conegiorno/StanowiskoChwytak/README.md

#### Budowa stanowiska do rozwoju metod estymacji siły chwytu chwytaka antropomorficznego
Niniejsze repozytorium jest projektem pracy magisterskiej.
