conegiorno/StanowiskoChwytak/(list of files, cad)

Other CAD files:
mechanical_parts/gripper/assembly/zlozenie_naped_v2.iam
mechanical_parts/gripper/assembly/zlozenie_palec_lewy.iam
mechanical_parts/gripper/assembly/zlozenie_palec_prawy.iam
mechanical_parts/gripper/assembly/zlozenie_ramka.iam
mechanical_parts/gripper/assembly/zlozenie_wszystko.iam
mechanical_parts/gripper/parts/belka_poprzeg.ipt
mechanical_parts/gripper/parts/belka_wzdluz.ipt
mechanical_parts/gripper/parts/czujnik_nacisku.ipt
mechanical_parts/gripper/parts/finger_rig.ipt
mechanical_parts/gripper/parts/holder_v2.ipt
mechanical_parts/gripper/parts/kolo_napedowe.ipt
mechanical_parts/gripper/parts/motor_clamp_v2.ipt
mechanical_parts/gripper/parts/motor_rig_v2.ipt
mechanical_parts/gripper/parts/motor_rig_v3.ipt
mechanical_parts/gripper/parts/nit_skrecany.ipt
mechanical_parts/gripper/parts/opuszek.ipt
mechanical_parts/gripper/parts/palec1.ipt
mechanical_parts/gripper/parts/palec2.ipt
mechanical_parts/gripper/parts/palec3.ipt
mechanical_parts/gripper/parts/paliczek_v2.ipt
mechanical_parts/gripper/parts/pokrywka.ipt
mechanical_parts/gripper/parts/potencjometr.ipt
mechanical_parts/gripper/parts/potentiometr_case.ipt
mechanical_parts/gripper/parts/pret20mm.ipt
mechanical_parts/gripper/parts/pret22mm.ipt
mechanical_parts/gripper/parts/tuleja.ipt
mechanical_parts/gripper/parts/tweaker.ipt
mechanical_parts/gripper/parts/wciskacz_v2.ipt
mechanical_parts/sensor_accesoories/hemisphere_1.ipt
mechanical_parts/sensor_accesoories/hemisphere_2.ipt
mechanical_parts/sensor_accesoories/noga1.ipt
mechanical_parts/sensor_accesoories/noga2.ipt
mechanical_parts/sensor_accesoories/semicylinder_1.ipt
mechanical_parts/sensor_accesoories/semicylinder_2.ipt
mechanical_parts/sensor_accesoories/stojak.iam
mechanical_parts/sensor_accesoories/stojak.ipt
