conegiorno/StanowiskoChwytak/documentation/schemat_elektroniczny.pdf

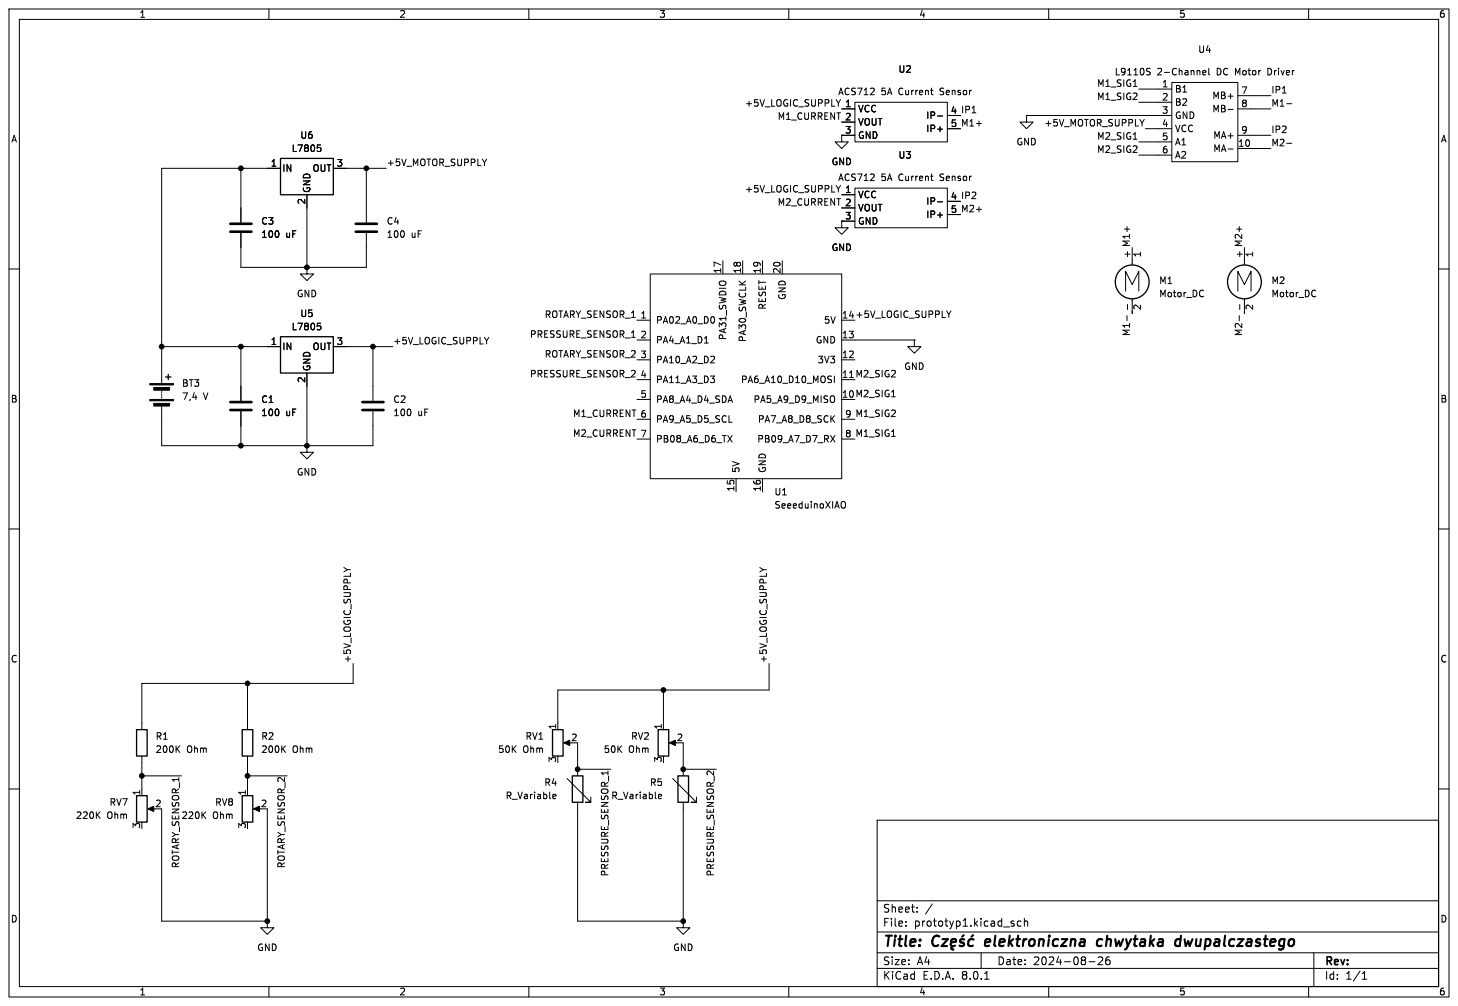
[picture p1: page 1]

GND
ACS712 5A Current Sensor VCC 1 VOUT 2 GND 3

2 OUT 3 U2 VCC 1 VOUT 2 GND 3
