conegiorno/StanowiskoChwytak/documentation/zlozenie_naped.pdf

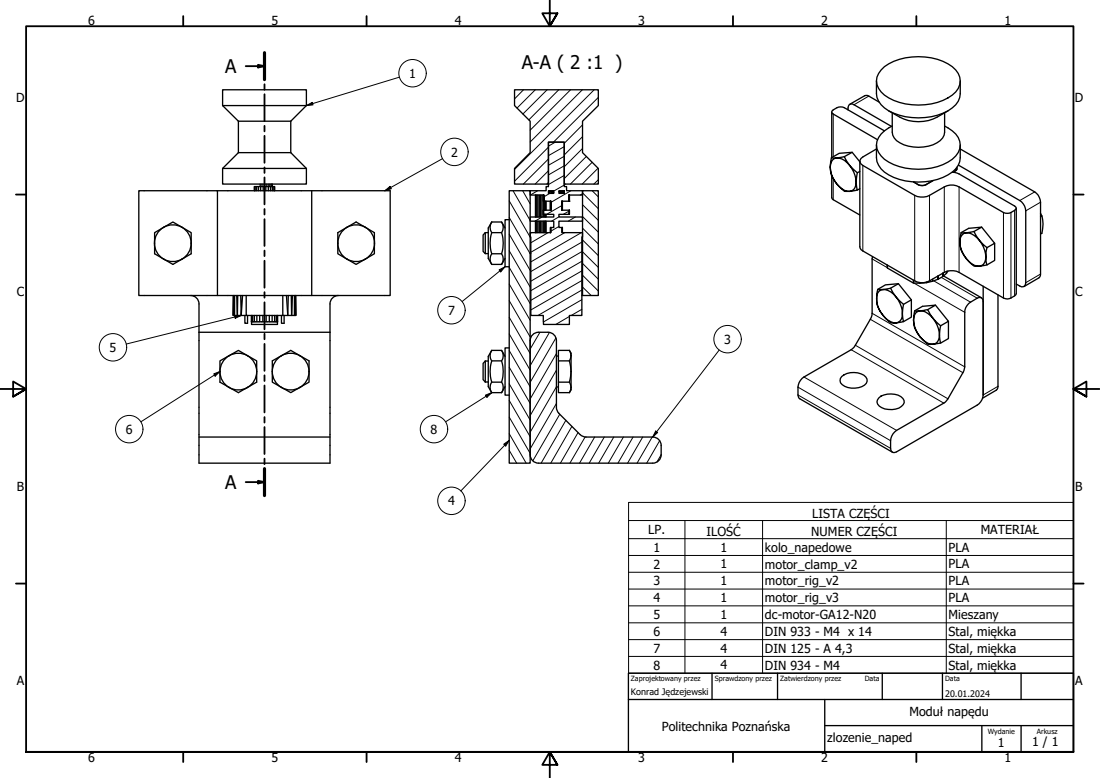
[picture p2: page 1]
LISTA CZĘŚCI

LP. | ILOŚĆ | NUMER CZĘŚCI | MATERIAŁ
1 | 1 | kolo_napedowe | PLA
2 | 1 | motor_clamp_v2 | PLA
3 | 1 | motor_rig_v2 | PLA
4 | 1 | motor_rig_v3 | PLA
5 | 1 | dc-motor-GA12-N20 | Mieszany
6 | 4 | DIN 933 - M4 x 14 | Stal, miękka
7 | 4 | DIN 125 - A 4,3 | Stal, miękka
8 | 4 | DIN 934 - M4 | Stal, miękka
Zaprojektowany przez Konrad Jędzejewski | Sprawdzony przez | Zatwierdzony przez Data | | Data 20.01.2024

Politechnika Poznańska | Moduł napędu

zlozenie_naped | Wydanie 1 | Arkusz 1 / 1
