conegiorno/StanowiskoChwytak/documentation/zlozenie_palec_lewy.pdf

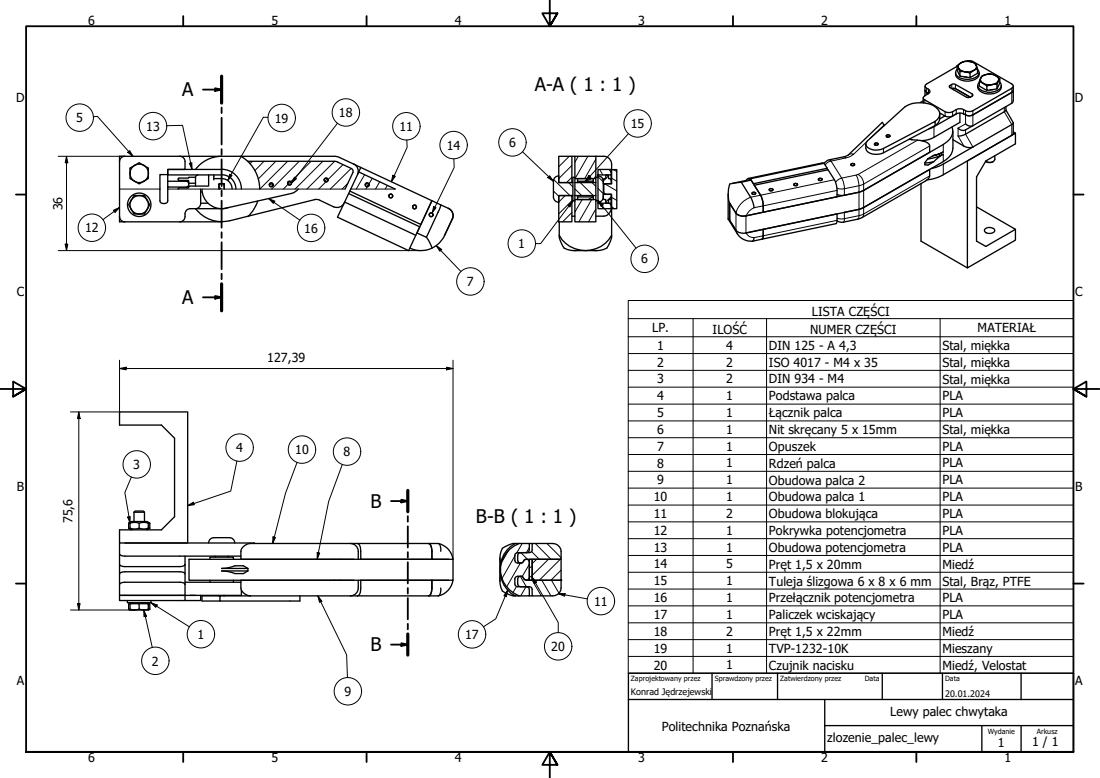
[picture p3: page 1]

L P . | Ś Ć I L O | Ś N U M E R C Z Ę C I | M AT E R I A Ł
1 | 4 | D I N 1 2 5 -A 4 , 3 | S t al, m i ę k k a
2 | 2 | I S O 4 0 1 7 -M 4 x 3 5 | S t al, m i ę k k a
3 | 2 | D I N 9 3 4 -M 4 | S t al, m i ę k k a
4 | 1 | P o d s t a w a p alc a | P LA
5 | 1 | Ł ą c z n i k p alc a | P LA
6 | 1 | N i t s k r ę c a n y 5 x 1 5 m m | S t al, m i ę k k a
7 | 1 | O p u s z e k | P LA
8 | 1 | R d z e ń p alc a | P LA
9 | 1 | O b u d o w a p alc a 2 | P LA
1 0 | 1 | O b u d o w a p alc a 1 | P LA
1 1 | 2 | O b u d o w a blo k u j ą c a | P LA
1 2 | 1 | P o k r y w k a p o t e n cj o m e t r a | P LA
1 3 | 1 | O b u d o w a p o t e n cj o m e t r a | P LA
1 4 | 5 | P r ę t 1 , 5 x 2 0 m m | M i e d ź
1 5 | 1 | T ulej a śli z g o w a 6 x 8 x 6 m m | S t al, B r ą z , P T F E
1 6 | 1 | P r z e ł ą c z n i k p o t e n cj o m e t r a | P LA
1 7 | 1 | P ali c z e k w c i s k a j ą c y | P LA
1 8 | 2 | P r ę t 1 , 5 x 2 2 m m | M i e d ź

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
