conegiorno/StanowiskoChwytak/documentation/zlozenie_palec_prawy.pdf

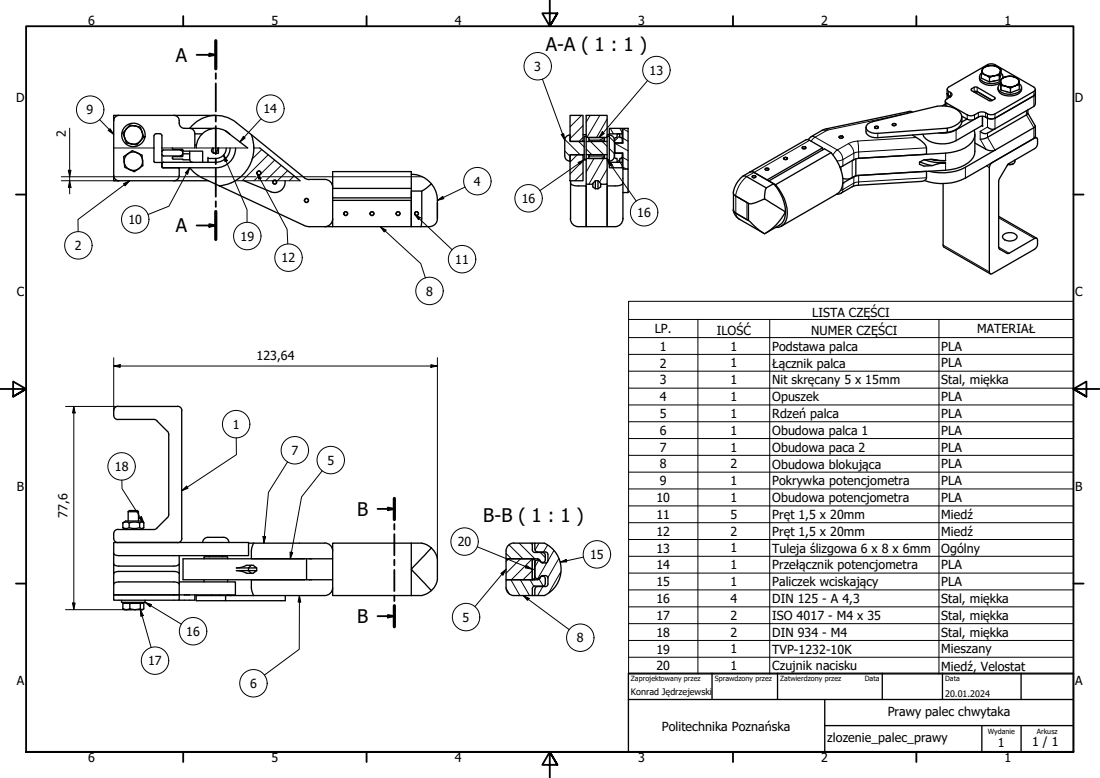
[picture p4: page 1]
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
