conegiorno/StanowiskoChwytak/documentation/zlozenie_ramka.pdf

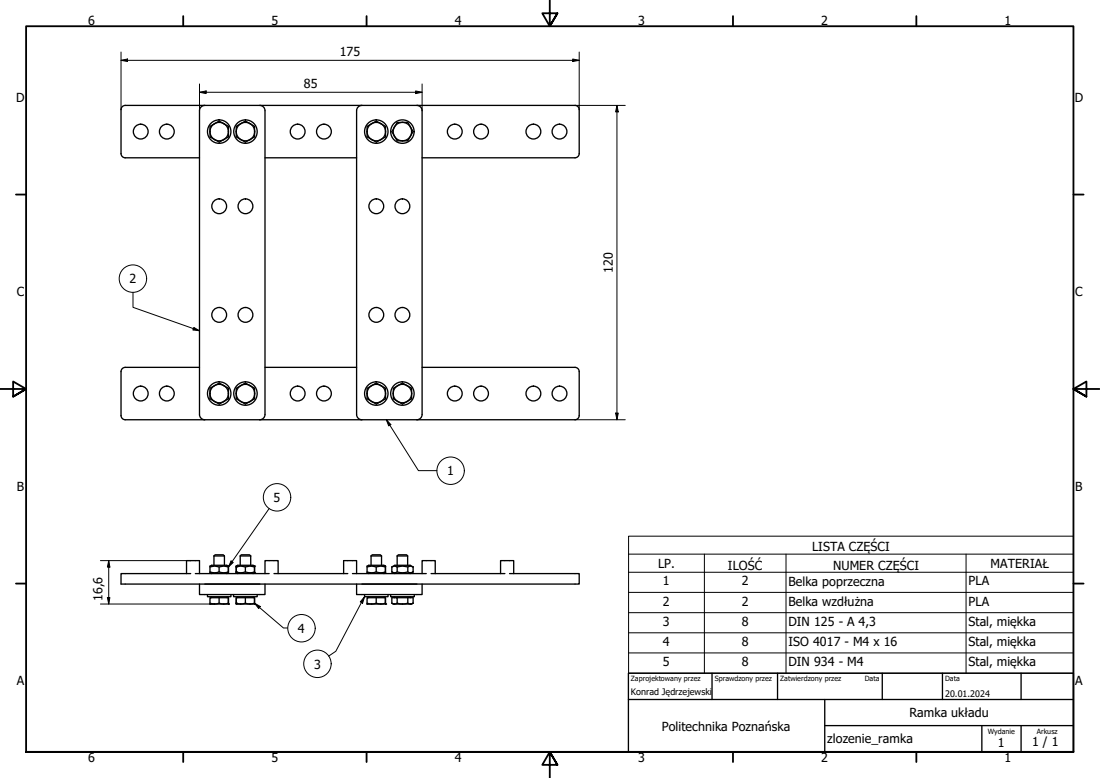
[picture p5: page 1]
LISTA CZĘŚCI

LP. | ILOŚĆ | NUMER CZĘŚCI | MATERIAŁ
1 | 2 | Belka poprzeczna | PLA
2 | 2 | Belka wzdłużna | PLA
3 | 8 | DIN 125 - A 4,3 | Stal, miękka
4 | 8 | ISO 4017 - M4 x 16 | Stal, miękka
5 | 8 | DIN 934 - M4 | Stal, miękka

Zaprojektowany przez Konrad Jędrzejewski | Sprawdzony przez | Zatwierdzony przez Data | | Data 20.01.2024

Politechnika Poznańska | Ramka układu

zlozenie_ramka | Wydanie 1 | Arkusz 1 / 1
