conegiorno/StanowiskoChwytak/documentation/zlozenie_wszystko.pdf

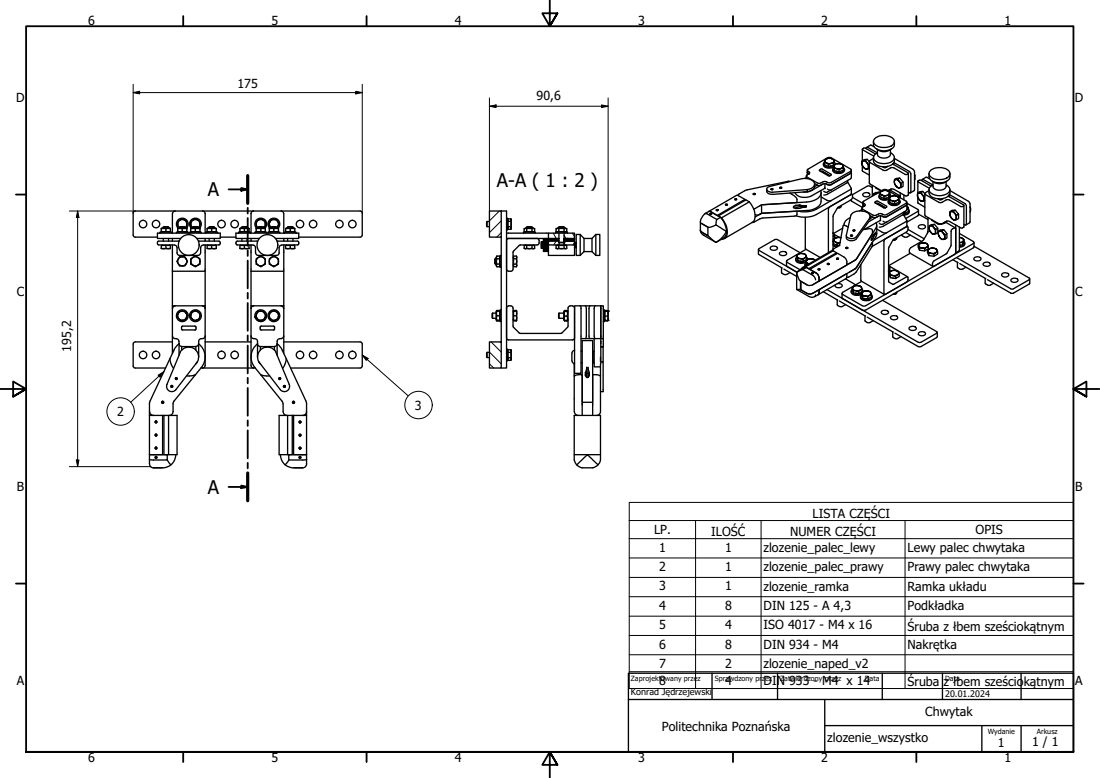
[picture p6: page 1]
LISTA CZĘŚCI

LP. | ILOŚĆ | NUMER CZĘŚCI | OPIS
1 | 1 | zlozenie_palec_lewy | Lewy palec chwytaka
2 | 1 | zlozenie_palec_prawy | Prawy palec chwytaka
3 | 1 | zlozenie_ramka | Ramka układu
4 | 8 | DIN 125 - A 4,3 | Podkładka
5 | 4 | ISO 4017 - M4 x 16 | Śruba z łbem sześciokątnym
6 | 8 | DIN 934 - M4 | Nakrętka
7 | 2 | zlozenie_naped_v2
8 Zaprojektowany przez | | 4 Sprawdzony przez | DIN 933 - M4 x 14 | Zatwierdzony przez Data | Śruba | z łbem sześciokątnym Data
Konrad Jędrzejewski | | | | | | 20.01.2024
Politechnika Poznańska | Chwytak

zlozenie_wszystko | Wydanie 1 | Arkusz 1 / 1
